Cpulido335/gh1/GH1_CAD_File.FCStd

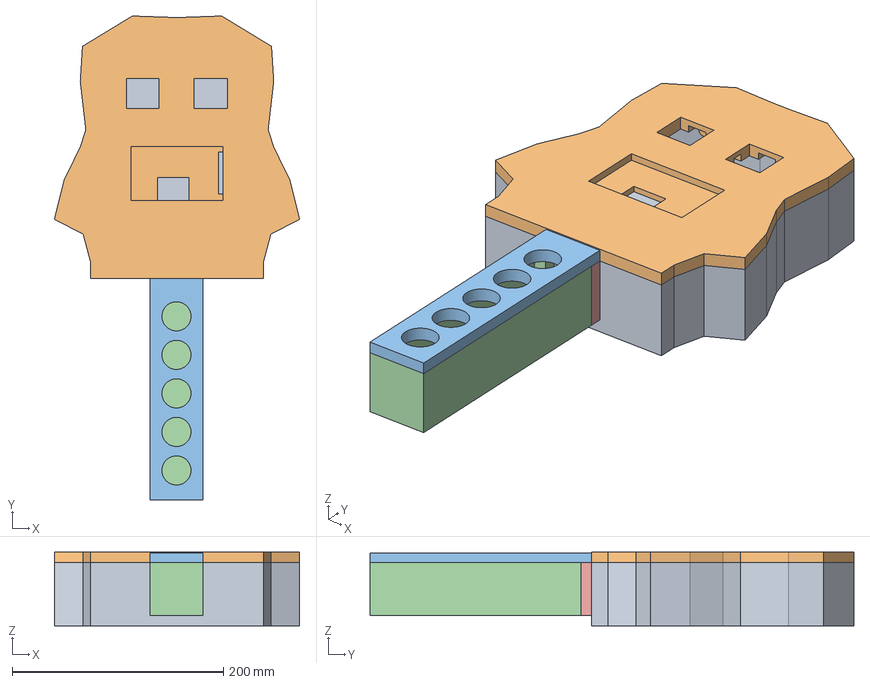
[picture p42: CAD file, 2026-06-29]
GH1_CAD_File.FCStd
232.4 x 458.6 x 70.0 mm
buildplate
faceplate body
faceplate neck
Slice.1
Slice.0
