Cpulido335/gh1/STL Files/guitar-body-faceplate.stl

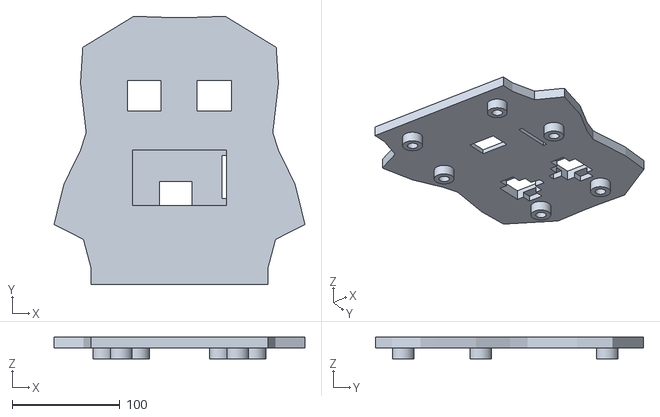
[picture p43: CAD file, 2026-06-29]
STL Files/guitar-body-faceplate.stl
232.4 x 248.6 x 20.0
