Cpulido335/gh1/STL Files/neck-body-faceplate.stl

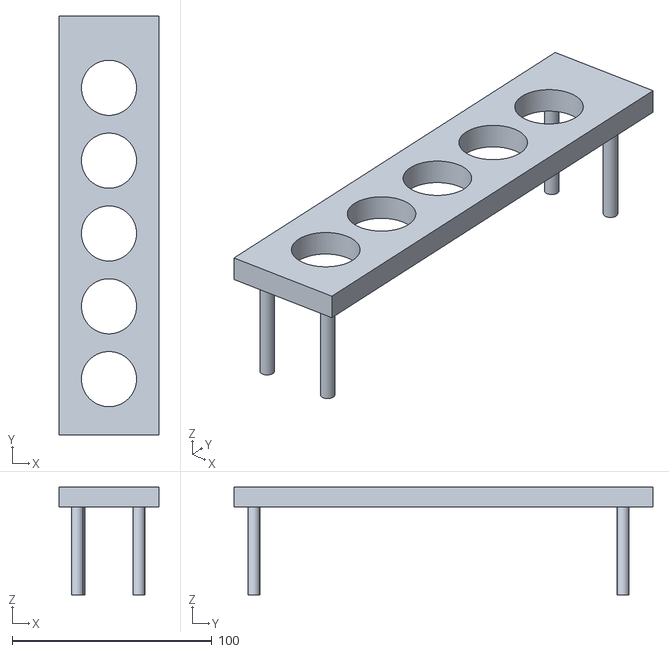
[picture p44: CAD file, 2026-06-29]
STL Files/neck-body-faceplate.stl
50.0 x 210.0 x 54.0
