Cpulido335/gh1/STL Files/neck-body.stl

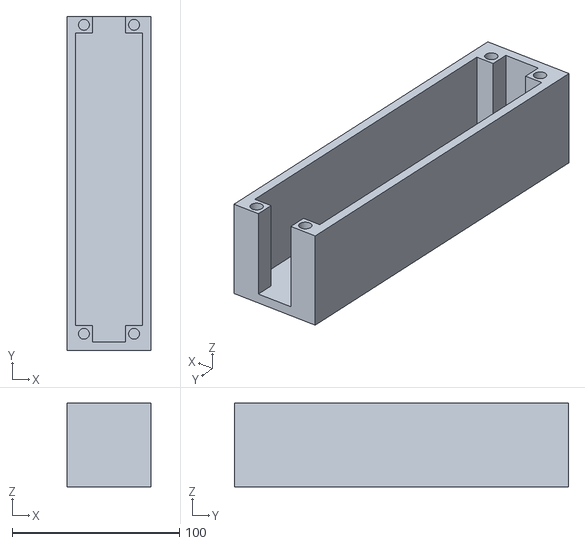
[picture p45: CAD file, 2026-06-29]
STL Files/neck-body.stl
50.0 x 200.0 x 50.0
