Cpulido335/gh1/STL Files/neck-body-union-piece.stl

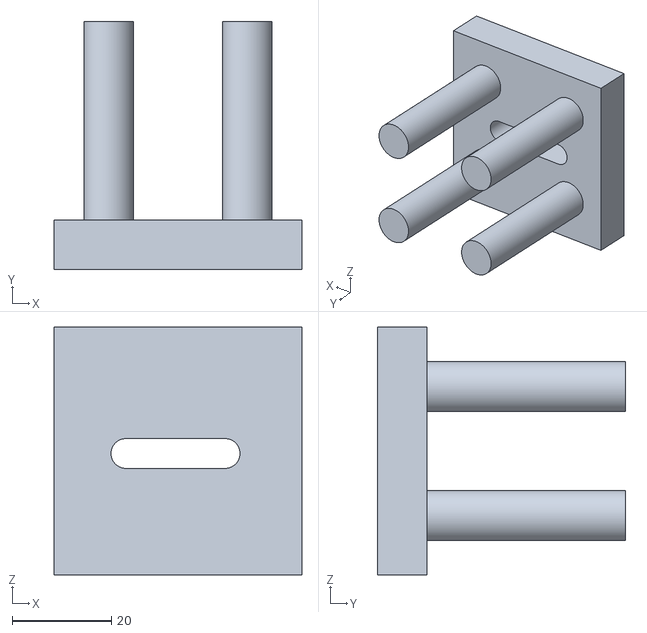
[picture p46: CAD file, 2026-06-29]
STL Files/neck-body-union-piece.stl
50.0 x 50.0 x 50.0
