Cpulido335/gh1/STL Files/guitar-body.stl

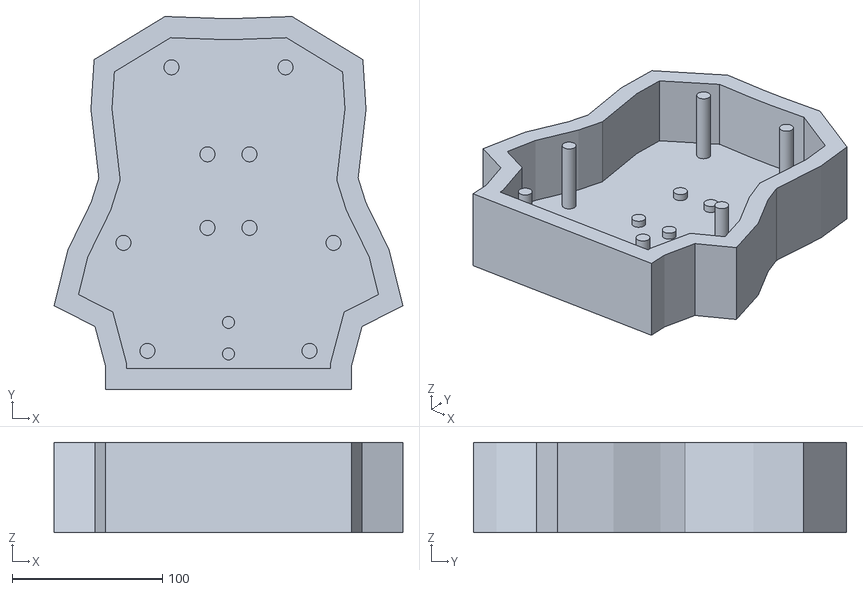
[picture p47: CAD file, 2026-06-29]
STL Files/guitar-body.stl
232.4 x 248.6 x 60.0
