Cpulido335/gh1/GH1-project/Core/Src/main.c

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
/* Includes ------------------------------------------------------------------*/
#include "main.h"
#include "fatfs.h"

/* USER CODE BEGIN Includes */

#include "ili9341.h"
#include "game.h"
#include "audio.h" //TODO FOR TESTING TESTTONE
/* USER CODE END Includes */

DAC_HandleTypeDef hdac;
DMA_HandleTypeDef hdma_dac1;

SD_HandleTypeDef hsd;
DMA_HandleTypeDef hdma_sdio;

SPI_HandleTypeDef hspi1;

TIM_HandleTypeDef htim7;

PCD_HandleTypeDef hpcd_USB_OTG_FS;

/* USER CODE BEGIN PV */
uint32_t loop_count = 0;


/* USER CODE END PV */

void SystemClock_Config(void);
static void MX_GPIO_Init(void);
static void MX_DMA_Init(void);
static void MX_USB_OTG_FS_PCD_Init(void);
static void MX_SPI1_Init(void);
static void MX_SDIO_SD_Init(void);
static void MX_DAC_Init(void);
static void MX_TIM7_Init(void);
/* USER CODE BEGIN 0 */
uint8_t BSP_SD_IsDetected(void) //@JAH override this function to make it always think there's an SD card since its just another thing that can break
{
	__IO uint8_t status = SD_PRESENT;

//	if (HAL_GPIO_REadPin(SD_DETECT_GPIO_PORT, SD_DETECT_PIN) != GPIO_PIN_RESET) {
//		status = SD_NOT_PRESENT;
//	}
//
	return status;
}
/* USER CODE END 0 */

/**
  * @brief  The application entry point.
  * @retval int
  */
int main(void)
{

  /* MCU Configuration--------------------------------------------------------*/

  /* Reset of all peripherals, Initializes the Flash interface and the Systick. */
  HAL_Init();

  /* Configure the system clock */
  SystemClock_Config();

  /* Initialize all configured peripherals */
  MX_GPIO_Init();
  MX_DMA_Init();
  MX_USB_OTG_FS_PCD_Init();
  MX_SPI1_Init();
  MX_SDIO_SD_Init();
  MX_FATFS_Init();
  MX_DAC_Init();
  MX_TIM7_Init();
  /* USER CODE BEGIN 2 */
	//@JAH this is the little block  from STM32Worlds video that makes sure you can read the card and SDIO initialized correctly
	printf("\n\n\n\n -------- \nStarting\n");


	//check SD initialization
	volatile uint32_t sd_block_size;
	volatile uint32_t sd_block_nbr;
	volatile uint32_t sd_card_size_kb;
	volatile uint32_t sd_card_version;

	sd_block_size   = hsd.SdCard.BlockSize;
	sd_block_nbr    = hsd.SdCard.BlockNbr;
	sd_card_size_kb = (hsd.SdCard.BlockSize * hsd.SdCard.BlockNbr) / 1000;
	sd_card_version = hsd.SdCard.CardVersion;

	//MOUNT SD card volume so FatFs file operations (open/read/write) can be used
	if (f_mount(&SDFatFS, (TCHAR const*) SDPath, 0) != FR_OK) { //@JAH TODO PROBLEM 0 could calso be "0:"
		printf ("Unable to mount disk\n");
		Error_Handler() ;
	}


	ILI9341_Init(); //initialize the ili9341
	ILI9341_FillScreen(ILI9341_BLUE);
	ILI9341_FillScreen(ILI9341_BLACK);
	init_game();
	//Audio_TestTone();


	uint32_t current_tick = 0;
	uint32_t last_tick = 0;
	uint32_t delta = 0;

	static uint32_t loop_counter = 0;   // counts loop iterations
	static uint32_t fps_timer   = 0;    // timestamp of last report
  /* USER CODE END 2 */

  /* Infinite loop */
  /* USER CODE BEGIN WHILE */
	while (1)
	{
    /* USER CODE END WHILE */

    /* USER CODE BEGIN 3 */


		uint32_t current_tick = HAL_GetTick();
		float delta = (current_tick - last_tick) / 1000.0f; // convert ms → seconds //TODO expensive operation
		last_tick = current_tick;

		loop_counter++;


		if (current_tick - fps_timer >= 1000) //one second elapsed //FPS COUNTER
		{
		    //print number of loops
		    printf("Loops in last second: %lu\n", loop_counter);

		    loop_counter = 0;        //reset counter
		    fps_timer = current_tick; //reset timer
		}


		handle_events();
		update_game(delta);
		display_game();
	}
  /* USER CODE END 3 */
}

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
