Cpulido335/gh1/GH1-project/gh1-project.ioc

Mcu.UserName=STM32F407ZGTx
PA11.Signal=USB_OTG_FS_DM
PA12.Signal=USB_OTG_FS_DP
PA15.GPIO_Label=SD_DETECT
PA15.Signal=GPIO_Input
PA4.Signal=COMP_DAC1_group
PA5.Signal=SPI1_SCK
PA7.Signal=SPI1_MOSI
PB0.GPIO_Label=SPI_RESET
PB0.Signal=GPIO_Output
PB3.GPIO_Label=btn4
PB3.Signal=GPIO_Input
PC12.Signal=SDIO_CK
PC4.GPIO_Label=SPI_CS
PC4.Signal=GPIO_Output
PC5.GPIO_Label=SPI_DC
PC5.Signal=GPIO_Output
PC8.Signal=SDIO_D0
PD2.Signal=SDIO_CMD
PD4.GPIO_Label=btn0
PD4.Signal=GPIO_Input
PD6.GPIO_Label=btn1
PD6.Signal=GPIO_Input
PG11.GPIO_Label=btn3
PG11.Signal=GPIO_Input
PG9.GPIO_Label=btn2
PG9.Signal=GPIO_Input
PH0-OSC_IN.Signal=RCC_OSC_IN
PH1-OSC_OUT.Signal=RCC_OSC_OUT
