Cpulido335/gh1/GH1-project/Core/Inc/main.h

#define SPI_CS_Pin GPIO_PIN_4
#define SPI_CS_GPIO_Port GPIOC
#define SPI_DC_Pin GPIO_PIN_5
#define SPI_DC_GPIO_Port GPIOC
#define SPI_RESET_Pin GPIO_PIN_0
#define SPI_RESET_GPIO_Port GPIOB
#define SD_DETECT_Pin GPIO_PIN_15
#define SD_DETECT_GPIO_Port GPIOA
#define btn0_Pin GPIO_PIN_4
#define btn0_GPIO_Port GPIOD
#define btn1_Pin GPIO_PIN_6
#define btn1_GPIO_Port GPIOD
#define btn2_Pin GPIO_PIN_9
#define btn2_GPIO_Port GPIOG
#define btn3_Pin GPIO_PIN_11
#define btn3_GPIO_Port GPIOG
#define btn4_Pin GPIO_PIN_3
#define btn4_GPIO_Port GPIOB
