Cpulido335/gh1/(notices)

Notices in the files:
GH1-project/Core/Inc/main.h:
Copyright (c) 2026 STMicroelectronics.
All rights reserved.
This software is licensed under terms that can be found in the LICENSE file
